Gordoa40/SplitFlapDisplay/SplitFlapBusBoard/SplitFlapBusBoard.kicad_sch

## KiCad design SplitFlapBusBoard/SplitFlapBusBoard.kicad_sch (2025-11-17)

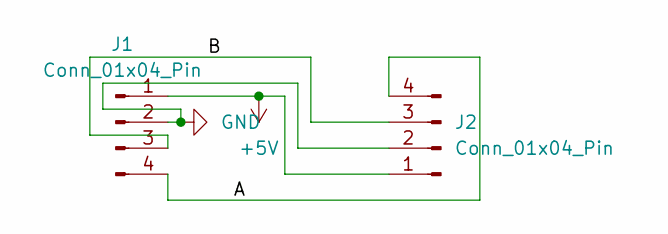
[picture p2: schematic SplitFlapBusBoard.kicad_sch]

Parts:
J1: Conn_01x04_Pin; PinHeader_1x04_P2.54mm_Vertical
J2: Conn_01x04_Pin; SplitFlapBusBar

Connections:
+5V: J1.1, J2.1
A: J1.4, J2.4
B: J1.3, J2.3
GND: J1.2, J2.2
