Gordoa40/SplitFlapDisplay/(commit log)

2025-11-17 Updated SplitFlapBusBoard
    [SplitFlapBusBoard.kicad_sch]
2026-04-27 Updated README.md and BOM.md
2026-04-28 Updated V3 board screenprint to include "V3"
    [SplitFlapDriverATtiny1616V3.kicad_pcb-B_Cu.gbr, SplitFlapDriverATtiny1616V3.kicad_pcb-B_Mask.gbr, SplitFlapDriverATtiny1616V3.kicad_pcb-B_Paste.gbr, SplitFlapDriverATtiny1616V3.kicad_pcb-B_Silkscreen.gbr, SplitFlapDriverATtiny1616V3.kicad_pcb-Edge_Cuts.gbr, SplitFlapDriverATtiny1616V3.kicad_pcb-F_Cu.gbr, SplitFlapDriverATtiny1616V3.kicad_pcb-F_Mask.gbr, SplitFlapDriverATtiny1616V3.kicad_pcb-F_Pas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]
2026-04-28 Updated BOM and README
